CameronBrooks11/Bayonet-Lock-SCAD/(list of files, cad)

Other CAD files:
examples/inner_3pin_thick_shell.scad
examples/outer_4pin_ccw.scad
bayonet_lock.scad
