CameronBrooks11/Bayonet-Lock-SCAD/(commit log)

2025-02-07 updated for use in pbr pbr project
    [bayonet_lock.scad]
2026-04-05 revise parameter set and clean up
    [bayonet_lock.scad]
2026-04-05 minor revisions
    [bayonet_lock.scad]
2026-04-05 fix fn preview order
    [bayonet_lock.scad]
2026-04-18 split into usage example
    [bayonet_lock.scad, example_usage.scad]
2026-04-18 Unify inner/outer bayonet into single bayonet module
    [bayonet_lock.scad, example_usage.scad]
2026-04-18 v0.4.0: naming cleanup, asserts, remove dead code
    [bayonet_lock.scad, example_usage.scad]
2026-04-18 chore: format and fix z fighting
    [bayonet_lock.scad]
2026-04-18 refactor: extract internal tube module
    [bayonet_lock.scad]
2026-04-18 chore: add version to comment header in scads
    [bayonet_lock.scad, example_usage.scad]
2026-04-18 fix: example neck mismatch case
    [bayonet_lock.scad, example_usage.scad]
2026-04-18 hardening: add asserts
    [bayonet_lock.scad]
2026-04-18 add input validation assertions; remove redundant asserts from _bayonet_channel
    [bayonet_lock.scad]
2026-04-18 fix rotate_extrude negative angle via pre-rotate + abs(torus_angle)
    [bayonet_lock.scad]
2026-04-18 pass mid_in_radius/mid_out_radius directly to _bayonet_channel; drop mid_radius recomputation
    [bayonet_lock.scad]
2026-04-18 add concise comments explaining angle offset and lock_pos asymmetries
    [bayonet_lock.scad]
2026-04-18 release 0.5.0: input validation, debug artifact removal, rotate_extrude fix, refactor, docs
    [bayonet_lock.scad, example_usage.scad]
2026-04-18 refactor examples: replace monolithic example_usage.scad with examples/ directory (4 focused files)
    [example_usage.scad, inner_2pin_no_neck.scad, minimal.scad, outer_3pin_with_neck.scad, outer_4pin_ccw.scad]
2026-04-18 update changelog for version 0.5.1
    [bayonet_lock.scad]
2026-04-18 fix rotate_extrude pre-rotate applied unconditionally; restrict to CW only
    [bayonet_lock.scad]
2026-04-18 release 0.5.2: fix CCW channel arc misalignment
    [bayonet_lock.scad]
2026-04-18 release 0.6.0: rename half/shell_thickness/sweep_angle/entry_depth, elevate _interface_r
    [bayonet_lock.scad, inner_2pin_no_neck.scad, minimal.scad, outer_3pin_with_neck.scad, outer_4pin_ccw.scad]
2026-04-18 release 0.7.0: assert pin_radius>0, document angle coefficients, fix minimal translate
    [bayonet_lock.scad, minimal.scad]
2026-04-18 fix: expose and use inner diameter on minimal example for computing separation
    [minimal.scad]
2026-04-19 change(api): mark tube as internal function
    [bayonet_lock.scad]
2026-04-19 feat: breaking change to api interface to make shell thickness optional
    [bayonet_lock.scad, inner_2pin.scad, inner_2pin_no_neck.scad, inner_3pin_thick_shell.scad, minimal.scad, outer_3pin.scad, outer_3pin_with_neck.scad]
2026-04-19 patch: validation on pin rad and small cleanups
    [bayonet_lock.scad, inner_3pin_thick_shell.scad, outer_3pin.scad]
2026-04-19 feat: ntry_depth is now optional in ayonet; when omitted
    [bayonet_lock.scad, inner_2pin.scad, inner_3pin_thick_shell.scad, minimal.scad, outer_3pin.scad, outer_4pin_ccw.scad]
2026-04-19 chore: remove unneeded check
    [bayonet_lock.scad]
2026-08-03 fix: place the pin sphere at the lock's channel end
    The pin half's locking sphere was measured up from the pin's own
    base, while the lock's channel end is measured down from the top.
    The two only coincide when entry_depth equals part_height / 2.
    That is the default, so the common case was unaffected, but any
    caller passing an explicit entry_depth got a pin sitting at the
    wrong height in the channel with no warning: at entry_depth = 3 on
    a part_height of 10 the sphere lands 4 mm below the channel and
    fouls the lock body.
    Place it at channel_depth instead, so both halves are authored in
    one frame and mate at a common origin for any entry depth. At the
    default entry_depth the generated geomet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
    [bayonet_lock.scad]
2026-08-08 feat(bayonet): add shell_only mode for fast assembly previews
    Omit the pin and channel features and emit only the bare coupling shell,
    so an assembly holding several bayonets stays cheap to pan. Same shell
    radii and height as the real part; the pin bosses are features and go
    with them, so a pin half previews pin_radius smaller in radius than it
    prints.
    Resolution order is explicit argument, then the dynamically scoped
    $bayonet_shell_only, then false. The special variable lets an assembly
    opt in once at its top level rather than threading an argument through
    every intermediate module, and reaches bayonet() calls buried inside
    consumer modules. No file-scope default is declared for it: a top-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
    [assembly_shell_only_preview.scad, bayonet_lock.scad]
2026-08-12 feat(bayonet): key the locked orientation with explicit pin angles (#2)
    Evenly spaced pins carry that spacing's rotational symmetry, so an n-pin
    coupling locks in n indistinguishable positions and nothing in the
    geometry prefers one. That is harmless while both halves are
    axisymmetric, and wrong as soon as one carries an orientation: a baffle
    plate or a tilted sensor seated one position out locks just as happily
    and points somewhere else, with no resistance to tell the assembler.
    pin_angles places the pins outright instead of spacing them evenly. Any
    unequal spacing removes the symmetry, which is how a BA15d lamp cap
    keys its two pins. Give exactly one of number_of_pins or pin_angles;
    numbe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
    [bayonet_lock.scad, keyed_3pin.scad]
2026-09-23 fix(bayonet): the entry transition is a sphere, not a hemisphere (#3)
    The lock half's rounded entry transition leaves coincident faces in the
    mesh. This drops the redundant cut that causes them.
    ## What happens
    The transition is built as a hemisphere:
    ```openscad
    translate([pin_interface_r, 0, channel_depth]) {
    difference() {
    sphere(_channel_radius);
    cylinder(h=_channel_radius * 2, r=_channel_radius * 2);
    }
    }
    ```
    The cutting cylinder's base plane passes exactly through the sphere's
    centre. That same plane is the swept torus's cross-section centre and
    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
    [bayonet_lock.scad]
